Dlloydev/Updi-Key/docs/images/Updifier.pdf

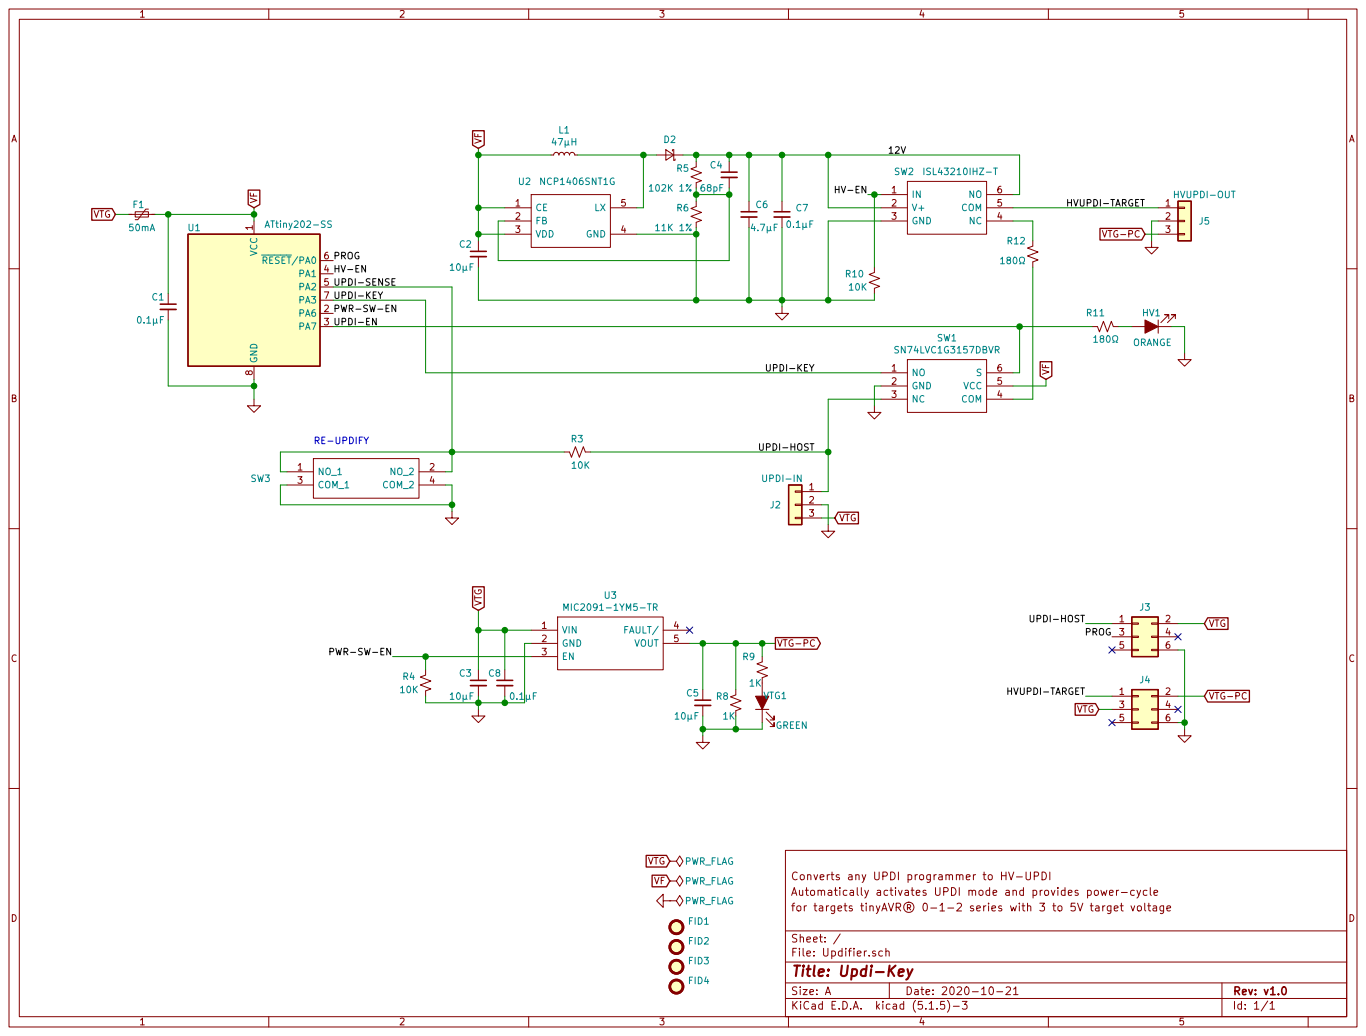
[picture p5: page 1]

Converts any UPDI programmer to HV-UPDI R8

Automatically activates UPDI mode and provides power-cycle
for targets tinyAVR® 0-1-2 series with 3 to 5V target voltage
File: Updifier.sch Sheet: /
Id: 1/1 Title: Updi-Key
