Dlloydev/Updi-Key/KiCad/Updifier/Updifier.kicad_pcb

## KiCad design KiCad/Updifier/Updifier.kicad_pcb (2020-10-21)

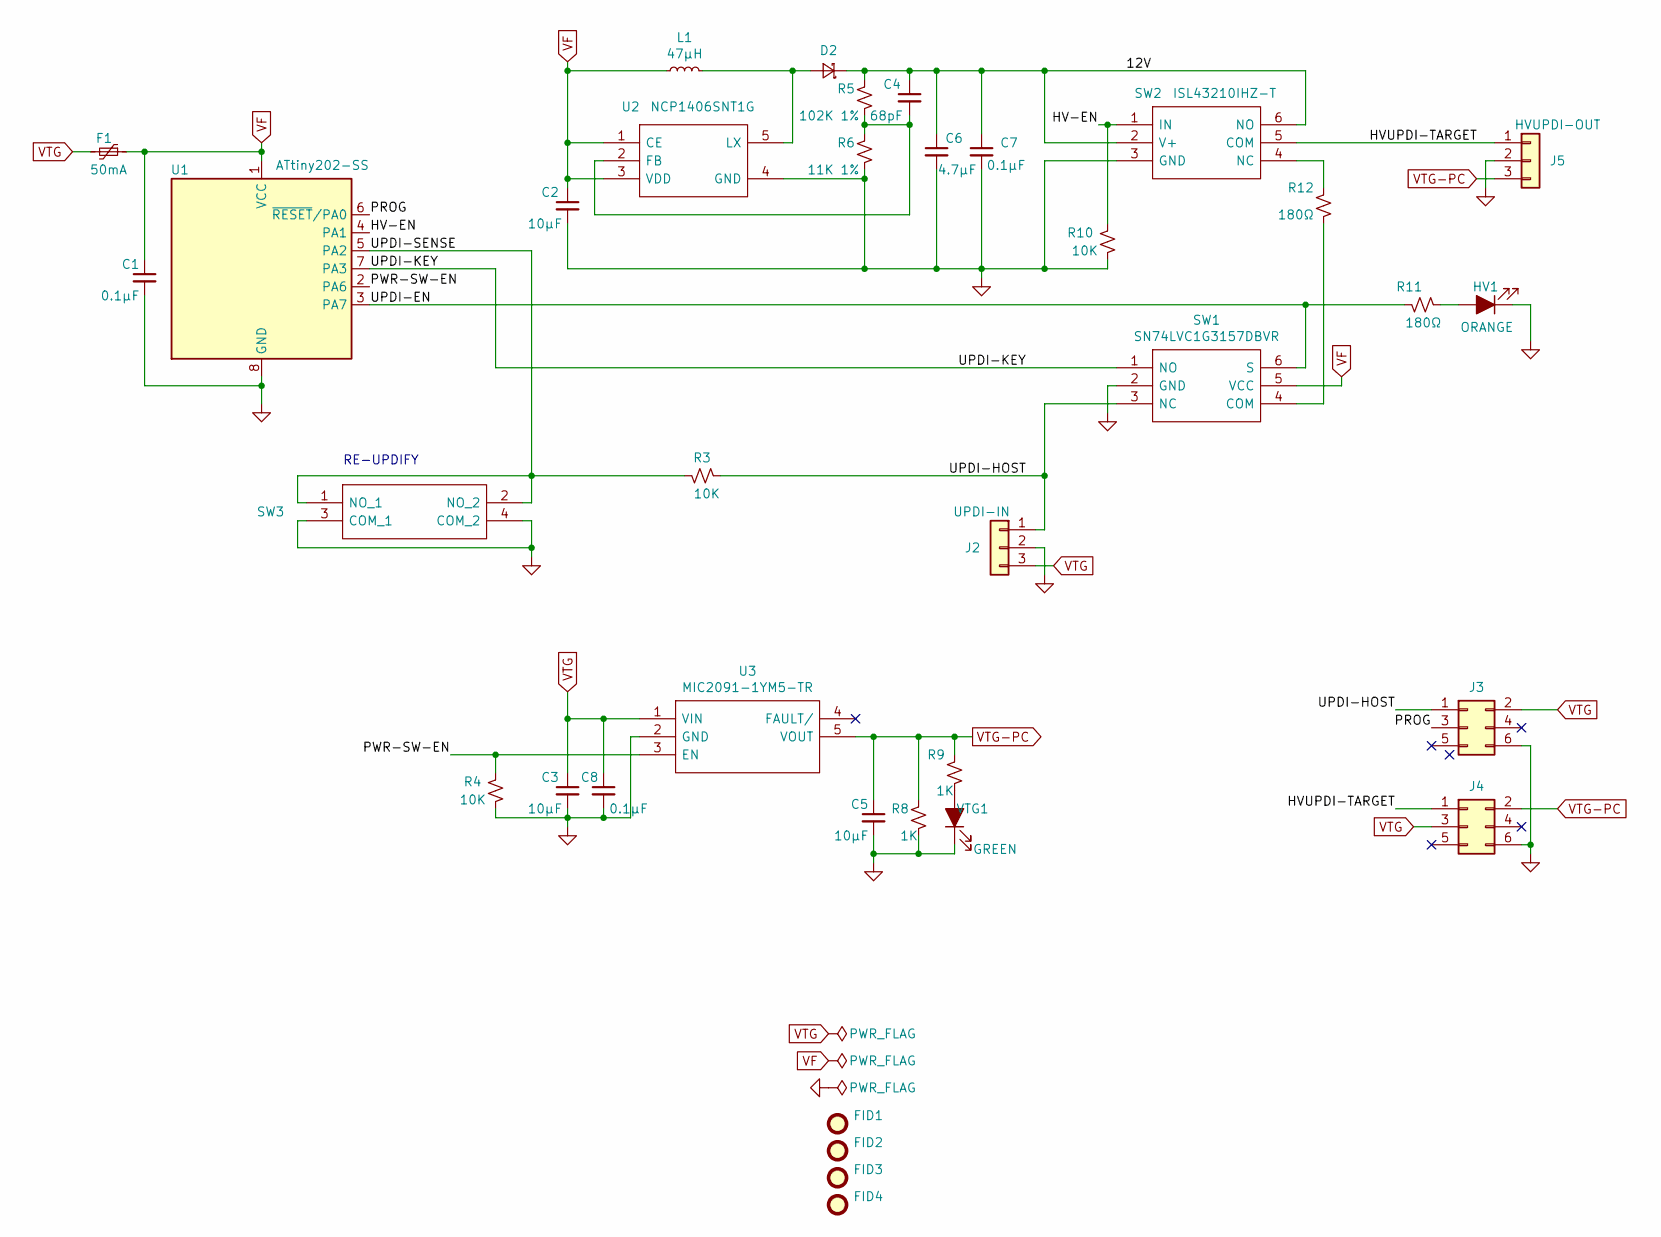
[picture p6: schematic Updifier.sch, UpdiKey]

Parts:
C1, C7, C8: 0.1µF; C_0603_1608Metric; Manufacturer_Part_Number CL10B104KB8NNNC; Digi-Key Part Number 1276-1000-1-ND
C2, C3, C5: 10µF; C_0603_1608Metric; Manufacturer_Part_Number LMK107BBJ106MALT; Digi-Key Part Number 587-3258-1-ND
C4: 68pF; C_0603_1608Metric; Manufacturer_Part_Number CC0603BRNPO9BNR68; Digi-Key Part Number 311-3842-1-ND
C6: 4.7µF; C_0603_1608Metric; Manufacturer_Part_Number CL10A475KO8NNNC; Digi-Key Part Number 1276-1784-1-ND
D2: PMEG4005CEJX; D_SOD-323F; Manufacturer_Part_Number PMEG4005CEJX; Digi-Key Part Number 1727-8169-1-ND
F1: 50mA; Fuse_0603_1608Metric; Manufacturer_Part_Number 0ZCM0005FF2G; Digi-Key Part Number 507-1816-1-ND
FID1, FID2, FID3, FID4: Fiducial; Fiducial_1mm_Mask2mm
HV1: ORANGE; LED_0603_1608Metric; Manufacturer_Part_Number APTD1608SECK/J4-PF; Digi-Key Part Number 754-1802-1-ND
J2: UPDI-IN; PinHeader_1x03_P2.54mm_Horizontal
J3: UPDI_IN6; PinHeader_2x03_P2.54mm_Vertical
J4: HVUPDI_OUT6; PinHeader_2x03_P2.54mm_Vertical
J5: HVUPDI-OUT; PinSocket_1x03_P2.54mm_Horizontal
L1: 47µH; L_1008_2520Metric; Manufacturer_Part_Number CBC2518T470K; Digi-Key Part Number 587-3060-1-ND
R3, R4, R10: 10K; R_0603_1608Metric; Manufacturer_Part_Number RK73B1JTTD103J; Digi-Key Part Number 2019-RK73B1JTTD103JCT-ND
R5: 102K 1%; R_0603_1608Metric; Manufacturer_Part_Number RC0603FR-07102KL; Digi-Key Part Number 311-102KHRCT-ND
R6: 11K 1%; R_0603_1608Metric; Manufacturer_Part_Number RC0603FR-0711KL; Digi-Key Part Number 311-11.0KHRCT-ND
R8, R9: 1K; R_0603_1608Metric; Manufacturer_Part_Number RK73B1JTTD102J; Digi-Key Part Number 2019-RK73B1JTTD102JCT-ND
R11, R12: 180Ω; R_0603_1608Metric; Manufacturer_Part_Number RK73B1JTTD181J; Digi-Key Part Number 2019-RK73B1JTTD181JCT-ND
SW1: SN74LVC1G3157DBVR; SOT95P280X145-6N; Manufacturer_Part_Number SN74LVC1G3157DBVR; Mouser Part Number 595-SN74LVC1G3157DBV
SW2: ISL43210IHZ-T; SOT95P280X145-6N; Manufacturer_Part_Number ISL43210IHZ-T; Mouser Part Number 968-ISL43210IHZ-T
SW3: PTS810SJG250SMTRLFS; Manufacturer_Part_Number PTS810SJG250SMTRLFS; Mouser Part Number 611-PTS810SJG250SMTR
U1: ATtiny202-SS; SOIC-8_3.9x4.9mm_P1.27mm; Manufacturer_Part_Number ATTINY202-SSNR; Digi-Key Part Number ATTINY202-SSNRCT-ND
U2: NCP1406SNT1G; SOT95P275X110-5N; Manufacturer_Part_Number NCP1406SNT1G; Mouser Part Number 863-NCP1406SNT1G
U3: MIC2091-1YM5-TR; SOT95P280X130-5N; Manufacturer_Part_Number MIC2091-1YM5-TR; Mouser Part Number 998-MIC2091-1YM5TR
VTG1: GREEN; LED_0603_1608Metric; Manufacturer_Part_Number LG Q396-PS-35; Digi-Key Part Number 475-3754-1-ND

Connections:
/12V: C4.1, C6.1, C7.1, D2.1 (K), R5.1, SW2.2 (V+), SW2.6 (NO)
/HV-EN: R10.1, SW2.1 (IN), U1.4 (PA1)
/HVUPDI-TARGET: J4.1, J5.1, SW2.5 (COM)
/PROG: J3.3, U1.6 (~RESET~/PA0)
/PWR-SW-EN: R4.1, U1.2 (PA6), U3.3 (EN)
/UPDI-EN: R11.2, SW1.6 (S), U1.3 (PA7)
/UPDI-HOST: J2.1, J3.1, R3.2, SW1.3 (NC)
/UPDI-KEY: SW1.1 (NO), U1.7 (PA3)
/UPDI-SENSE: R3.1, SW3.1 (NO_1), SW3.2 (NO_2), U1.5 (PA2)
GND: C1.2, C2.2, C3.2, C5.2, C6.2, C7.2, C8.2, HV1.1 (K), J2.2, J3.6, J4.6, J5.2, R4.2, R6.2, R8.2, R10.2, SW1.2 (GND), SW2.3 (GND), SW3.3 (COM_1), SW3.4 (COM_2), U1.8 (GND), U2.4 (GND), U3.2 (GND), VTG1.1 (K)
unnamed: C4.2, R5.2, R6.1, U2.2 (FB)
unnamed: D2.2 (A), L1.2, U2.5 (LX)
unnamed: HV1.2 (A), R11.1
unnamed: R9.2, VTG1.2 (A)
unnamed: R12.1, SW2.4 (NC)
unnamed: R12.2, SW1.4 (COM)
VF: C1.1, C2.1, F1.1, L1.1, SW1.5 (VCC), U1.1 (VCC), U2.1 (CE), U2.3 (VDD)
VTG: C3.1, C8.1, F1.2, J2.3, J3.2, J4.3, U3.1 (VIN)
VTG-PC: C5.1, J4.2, J5.3, R8.1, R9.1, U3.5 (VOUT)

Notes on the sheet:
RE-UPDIFY

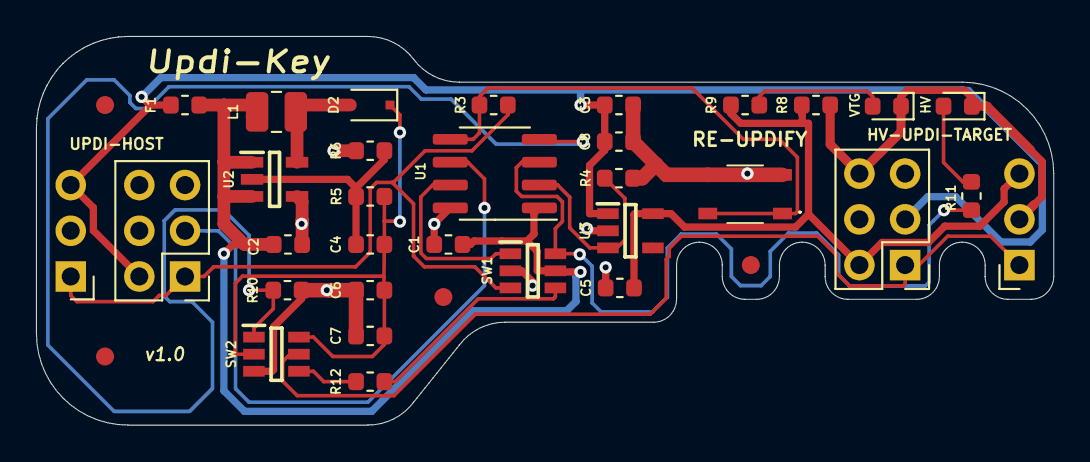
[picture p7: board Updifier.kicad_pcb from above]

Board: 2 copper layers, 56.5 x 21.6 mm, 36 parts (0 on the bottom side), 19 nets.
